CircuitCo/BeagleBone-LCD7-RevA3/README

The BeagleBone LCD7 is a top-level cape with touchscreen capability for use with BeagleBone boards. The top side of this cape features a 7" TFT LCD screen, which can display up to 800x480 resolution, as well as a 4-wire resistive touchscreen and five user buttons. The BeagleBone LCD7 Cape is reset and powered on by buttons. BeagleBone board and other capes are mounted on the backside.
