CircuitCo/BeagleBone-LCD7-RevA3/BeagleBone-LCD7-RevA3-bom.xls

BeagleBone LCD7 Cape |  |  | Revised: | 2012-10-03
BB-BONE-LCD7-01 Revision: A3
TOP LEVEL
ITM | QTY | DESCRIPTION | PART NUMBER | MAN | COMMENT
1 | 4 | #4 PEM NUTS | KFS2-440 | GLOBAL FASTENERS
2 | 4 | STDOFF HEX M/F #4 1.250"L ALUM | 8407K-ND | KEYSTONE
ITM | QTY | REF DESIGNATIORS | PART | PCB FOOTPRINT | DESCRIPTION | MAN | PART #
1 | 5 | C1,C2,C3,C4,C13 | 10uF,10V | 805 | CAP CER 10UF 10V Y5V 0805 | TDK | C2012Y5V1A106Z
2 | 20 | C5,C6,C7,C8,C9,C10,C11,C12,C14,C15,C16,C17,C18,C19,C20,C21,C22,C23,C24,C41 | 0.1uF | 402 | Capacitor 0.1uF 16V 10% 0402 X7R | Kemet | C0402C104K4RACT
3 | 1 | C25 | 6.8pF, 50v | c402-25 | CAP CER 6.8PF 50V C0G 0402 |  | GRM1555C1H6R8DZ01D
4 | 2 | C26,C27 | 22uF, 25v | c1206-40x70 | CAP CER 22UF 25V X5R 1206 |  | GRM31CR61E226KE15L
5 | 1 | C28 | 1nF, 25v | c402-25 | CAP CER 1000PF 50V 10% X7R 0402 |  | GRM155R71H102KA01D
6 | 5 | C29,C31,C32,C33,C35 | 0.22uF | c603-35x45 | CAP CER .22UF 50V Y5V 0603 |  | GRM188F51H224ZA01D
7 | 1 | C30 | 2.2nF | c402-25 | CAP CER 2200PF 50V 10% X7R 0402 |  | GRM155R71H222KA01D
8 | 2 | C34,C36 | 1uF, 10v | c603-35x45 | CAP CER 1.0UF 25V X5R 0603 |  | TMK107BJ105KA-T
9 | 1 | C37 | 4.7uF | c603-35x45 | CAP CER 4.7UF 6.3V X5R 0603 |  | GRM188R60J475ME19D
10 | 2 | C38,C40 | 4.7uF, 25V | c805-35x60 | CAP CER 4.7UF 50V X5R 10% 0805 |  | C2012X5R1H475K
11 | 1 | C39 | 47nF | c402-25 | CAP CER 0.047UF 25V X5R 0402 |  | TMK105B7473KV-F
12 | 1 | D1 | MBRM120L | powermite-case457-04 | DIODE SCHOTTKY 20V 1A POWERMITE |  | MBRM120LT3G
13 | 1 | D2 | BAT54S/SOT | sot23-28x44 | DIODE SCHOTTKY DUAL 30V SOT323 |  | BAT54SWT1G
14 | 2 | D3,D4 | LTST-C190GKT | led2-31sq | LED GREEN CLEAR 0603 SMD |  | LTST-C190GKT
15 | 2 | J1,J2 | MALE HEADER 2x23 | HEADER23X2 |  | MLE | BSTS-123-D-A-16-T-300-LF
16 | 0.25 | J3 | MALE HDR5x2 | HEADER10X2 |  | MLE | BSTS-123-D-A-16-T-300-LF
17 | 1 | J4 | FEMALE HDR5x2 | HEADER10X2 | NN HEADER FMAL 10PS.1" DL GOLD | MLE | SSHS-105-D-02-T-LF
18 | 2 | J5,J6 | FEMALE HEADER 2x23 | HEADER23X2 | NN HEADER FMAL 46PS.1" DL GOLD | MLE | SSHS-123-D-02-T-LF
19 | 1 | L1,L2 | 4.7uH | ind-lqh32m | INDUCTOR 4.7UH 20% 450MA 1210 |  | LQH32CN4R7M23L
20 | 1 | P1 | CONN_PWR1_2.5MM | CONN3-PWR-PJ102A | CONN POWER JACK 2.1MM |  | PJ-002A
21 | 1 | P2 | FH28-60S-0.5SH | conn-fh28-60s | CONN 60POS FPC 0.5MM SMD GOLD |  | FH28-60S-0.5SH(05)
22 | 1 | P3 | SFW4R-1STE1LF | conn4-24x79-sfw | Conn FFC/FPC Connector SKT 4 POS 1mm Solder RA |  | SFW4R-1ST
23 | 1 | P5 | SM02B-BHSS-1 | con2-bhs-jst | 2 Position 3.5mm Pitch Wire to Board Disconnectable Socket | JST | SM02B-BHSS-1-TB(LF)
24 | 1 | Q1 | FMMT458/SOT | sot23-28x44-bec | TRANS HP NPN 400V 225MA SOT23-3 |  | FMMT458TA
25 | 1 | Q2 | DMC56404 | SMini6-F3-B | TRANS PREBIASED DUAL NPN | Diodes, Inc | DDC114YU-7-F
26 | 0 | Q3 | BSS138, DNI |  | MOSFET Nchan 50V 200mA | Diodes Inc. | BSS138-7-F
27 | 20 | R1,R4,R7,R8,R10,R12,R13,R14,R15,R19,R21,R23,R25,R27,R29,R31,R33,R35,R37,R39 | 33402 | 402 | RES 33.0 OHM 1/16W 1% 0402 SMD | Yaego | RC0402FR-0733RL
28 | 20 | R2,R3,R5,R6,R9,R11,R16,R17,R18,R20,R22,R24,R26,R28,R30,R32,R34,R36,R38,R40 | 10402 | 402 | RES 10.0 OHM 1/16W 1% 0402 SMD | Yaego | RC0402FR-0710RL
29 | 0 | R102 | 10, DNI | 402
30 | 2 | R41,R51 | 62 | sm-7351-res-0402 | RES 62 OHM 1/16W 1% 0402 SMD |  | ERJ-2RKF62R0X
31 | 1 | R42 | 196 | 402 | RES 196 OHM 1/16W 1% 0402 SMD |  | ERJ-2RKF1960X
32 | 1 | R43 | 69.8 | sm-7351-res-0402 | RES 69.8 OHM 1/16W 1% 0402 SMD |  | ERJ-2RKF69R8X
33 | 1 | R44 | 40.2 | sm-7351-res-0402 | RES 40.2 OHM 1/16W 1% 0402 SMD |  | ERJ-2RKF40R2X
34 | 1 | R45 | 237 | sm-7351-res-0402 | RES 237 OHM 1/16W 1% 0402 SMD |  | ERJ-2RKF2370X
35 | 1 | R46 | 25 | R402-25 | RES 24.9 OHM 1/16W 1% 0402 SMD |  | ERJ-2RKF24R9X
36 | 1 | R47 | 165 | sm-7351-res-0402 | RES 165 OHM 1/16W 1% 0402 SMD |  | ERJ-2RKF1650X
37 | 1 | R48 | 64.9 | sm-7351-res-0402 | RES 64.9 OHM 1/16W 1% 0402 SMD |  | ERJ-2RKF64R9X
38 | 1 | R49 | 82.5 | sm-7351-res-0402 | RES 82 OHM 1/16W 1% 0402 SMD |  | ERJ-2RKF82R0X
39 | 1 | R50 | 240 | sm-7351-res-0402 | RES 240 OHM 1/16W 1% 0402 SMD |  | ERJ-2RKF2400X
40 | 13 | R52,R53,R71,R72,R75,R78,R79,R80,R81,R82,R83,R92,R93 | 10K | SM-7351-RES-0402 | Resistor 10Kohm 1/16W 5% 0402 | Rohm | MCR01MZPJ103
41 | 1 | R54 | 499K | c402-25 | RES 499K OHM 1/16W 1% 0402 SMD |  | ERJ-2RKF4993X
42 | 1 | R55 | 430K | c402-25 | RES 430K OHM 1/16W 1% 0402 SMD |  | ERJ-2RKF4303X
43 | 1 | R56 | 330K | c402-25 | RES 330K OHM 1/16W 1% 0402 SMD |  | ERJ-2RKF3303X
44 | 2 | R57 | 15K | c402-25 | RES 15K OHM 1/16W 1% 0402 SMD |  | ERJ-2RKF1502X
45 | 0 | R96 | 18K, DNI | c402-25 | RES 18K OHM 1/16W 1% 0402 SMD |  | ERJ-2RKF1802X
46 | 2 | R58,R62 | 56K | c402-25 | RES 56K OHM 1/16W 1% 0402 SMD |  | ERJ-2RKF5602X
47 | 1 | R59 | 750K | c402-25 | RES 750K OHM 1/16W 1% 0402 SMD |  | ERJ-2RKF7503X
48 | 1 | R60 | 680K | c402-25 | RES 680K OHM 1/16W 1% 0402 SMD |  | ERJ-2RKF6803X
49 | 1 | R61 | 130K | c402-25 | RES 130K OHM 1/16W 1% 0402 SMD |  | ERJ-2RKF1303X
50 | 1 | R63 | 330 | r402-25 | RES 330 OHM 1/10W 5% 0402 SMD |  | CRCW0402330RJNED
51 | 1 | R64 | 1E | c402-25 | RES 1.00 OHM 1/16W 1% 0402 SMD | Yaego | RC0402FR-071RL
52 | 2 | R65,R66 | 5.6K,5% | 402 | RES 5.6K OHM 1/16W 5% 0402 SMD | Yaego | RC0402JR-075K6L
53 | 3 | R67,R68,R69 | 4.75K | 402 | RES 4.75K OHM 1/16W 1% 0402 SMD | Stackpole Electronics | RMCF0402FT4K75
54 | 0 | R70,R73,R74,R76,R77 | 10K, DNI | SM-7351-RES-0402 | Resistor 10Kohm 1/16W 5% 0402 | Rohm | MCR01MZPJ103
55 | 8 | R85,R87,R89,R91,R95,R99 | 0 | c402-25 | Resistor Zero ohm Jumper 0402 | Yageo | RC0402JR-070RL
56 | 0 | R84,R86,R88,R90,R97,R98,R100 | 0, DNI | c402-25 | Resistor Zero ohm Jumper 0402 | Yageo | RC0402JR-070RL
57 | 1 | R94 | 470 | r402-25 | RES 470 OHM 1/10W 5% 0402 SMD |  | CRCW0402470RJNED
58 | 1 | R116 | 100K | 402 | RES 100K OHM 1/16W 1% 0402 SMD |  | ERJ-2RKF1003X
59 | 0 | R101 | 100K, DNI | 402 | RES 100K OHM 1/16W 1% 0402 SMD
60 | 1 | SW1 | SW DIP-2 | swdip4_100-339smd | SWITCH TAPE SEAL 2 POS SMD | CTS | 219-2MST
61 | 2 | S1,S6 | B3F-3100 | sw4-b3f-315x | SWITCH TACTILE SPST-NO 0.05A 24V, RA | Omron | B3F-3100
62 | 5 | S2,S3,S4,S5,S7 | B3F-1000 | SWRST4_177X256LS-1 | SWITCH TACTILE SPST-NO 0.05A 24V | Omron | B3F-1000
64 | 1 | U1 | 74avc32t245 | BGA96-ZKE | IC BUS TRANSCVR 32BIT 96BGA | TI | SN74AVC32T245ZKER
65 | 1 | U2 | TPS65105PWP | pwp24-14x70 |  | TI | TPS65105PWPR
66 | 1 | U3 | TPS61080DRC | drc10-11x33 | IC REG LDO CAP FREE 8-SON | TI | TPS61080DRC
67 | 1 | U4 | CAT24C256W | SOIC_8 | IC EEPROM 256KBIT 400KHZ 8SOIC | ON | CAT24C256WI-G
68 | 1 | LCD |  |  | 7" LCD PANEL | TF | TFC-S9700RTWV35TR-01
69 | 1 | PCB |  |  |  |  | BB-BONE-LCD7-PCB-04
