CircuitCo/BeagleBone-LCD7-RevA3/BeagleBone-LCD7-RevA3-schematic.pdf

# 12/14/2011 BBT

# DATE

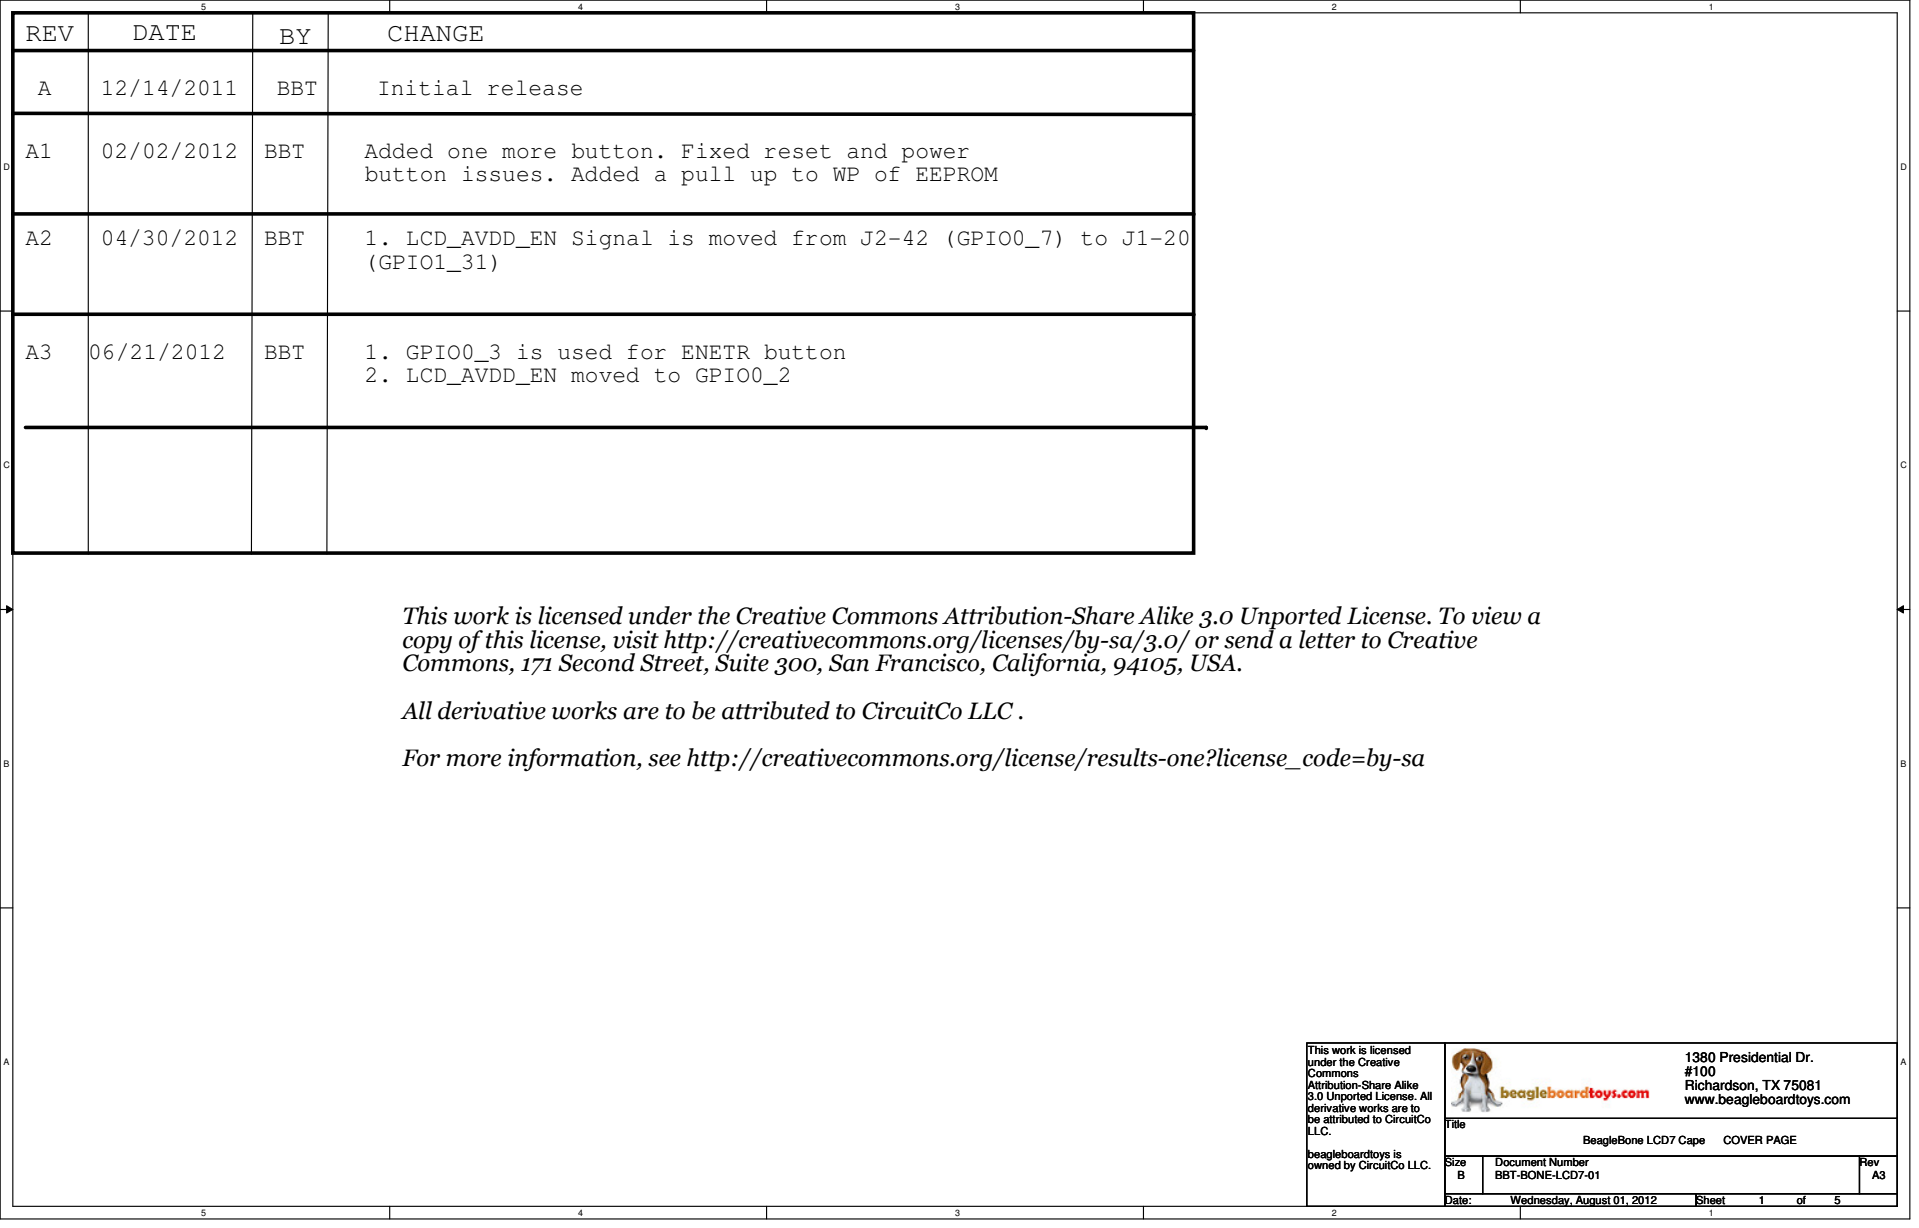
[picture p1: page 1]
REV; CHANGE; Initial release; BBT; Added one more button. Fixed reset and power; 1. LCD_AVDD_EN Signal is moved from J2-42 (GPIO0_7) to J1-20; (GPIO1_31); 1. GPIO0_3 is used for ENETR button; 2. LCD_AVDD_EN moved to GPIO0_2; Title; Size; Document Number; Rev; Date:; Sheet; BBT-BONE-LCD7-01; BeagleBone LCD7 Cape; COVER PAGE; Wednesday, August 01, 2012

button issues. Added a pull up to WP of EEPROM

This work is licensed under the Creative Commons Attribution-Share Alike 3.0 Unported License. To view a
copy of this license, visit http://creativecommons.org/licenses/by-sa/3.0/ or send a letter to Creative
Commons, 171 Second Street, Suite 300, San Francisco, California, 94105, USA.

All derivative works are to be attributed to CircuitCo LLC .

For more information, see http://creativecommons.org/license/results-one?license_code=by-sa

This work is licensed
under the Creative
Commons
Attribution-Share Alike
3.0 Unported License. All
derivative works are to
be attributed to CircuitCo
LLC.

1380 Presidential Dr.
Richardson, TX 75081
www.beagleboardtoys.com

beagleboardtoys is
owned by CircuitCo LLC.

# CONN A IN CONN A OUT

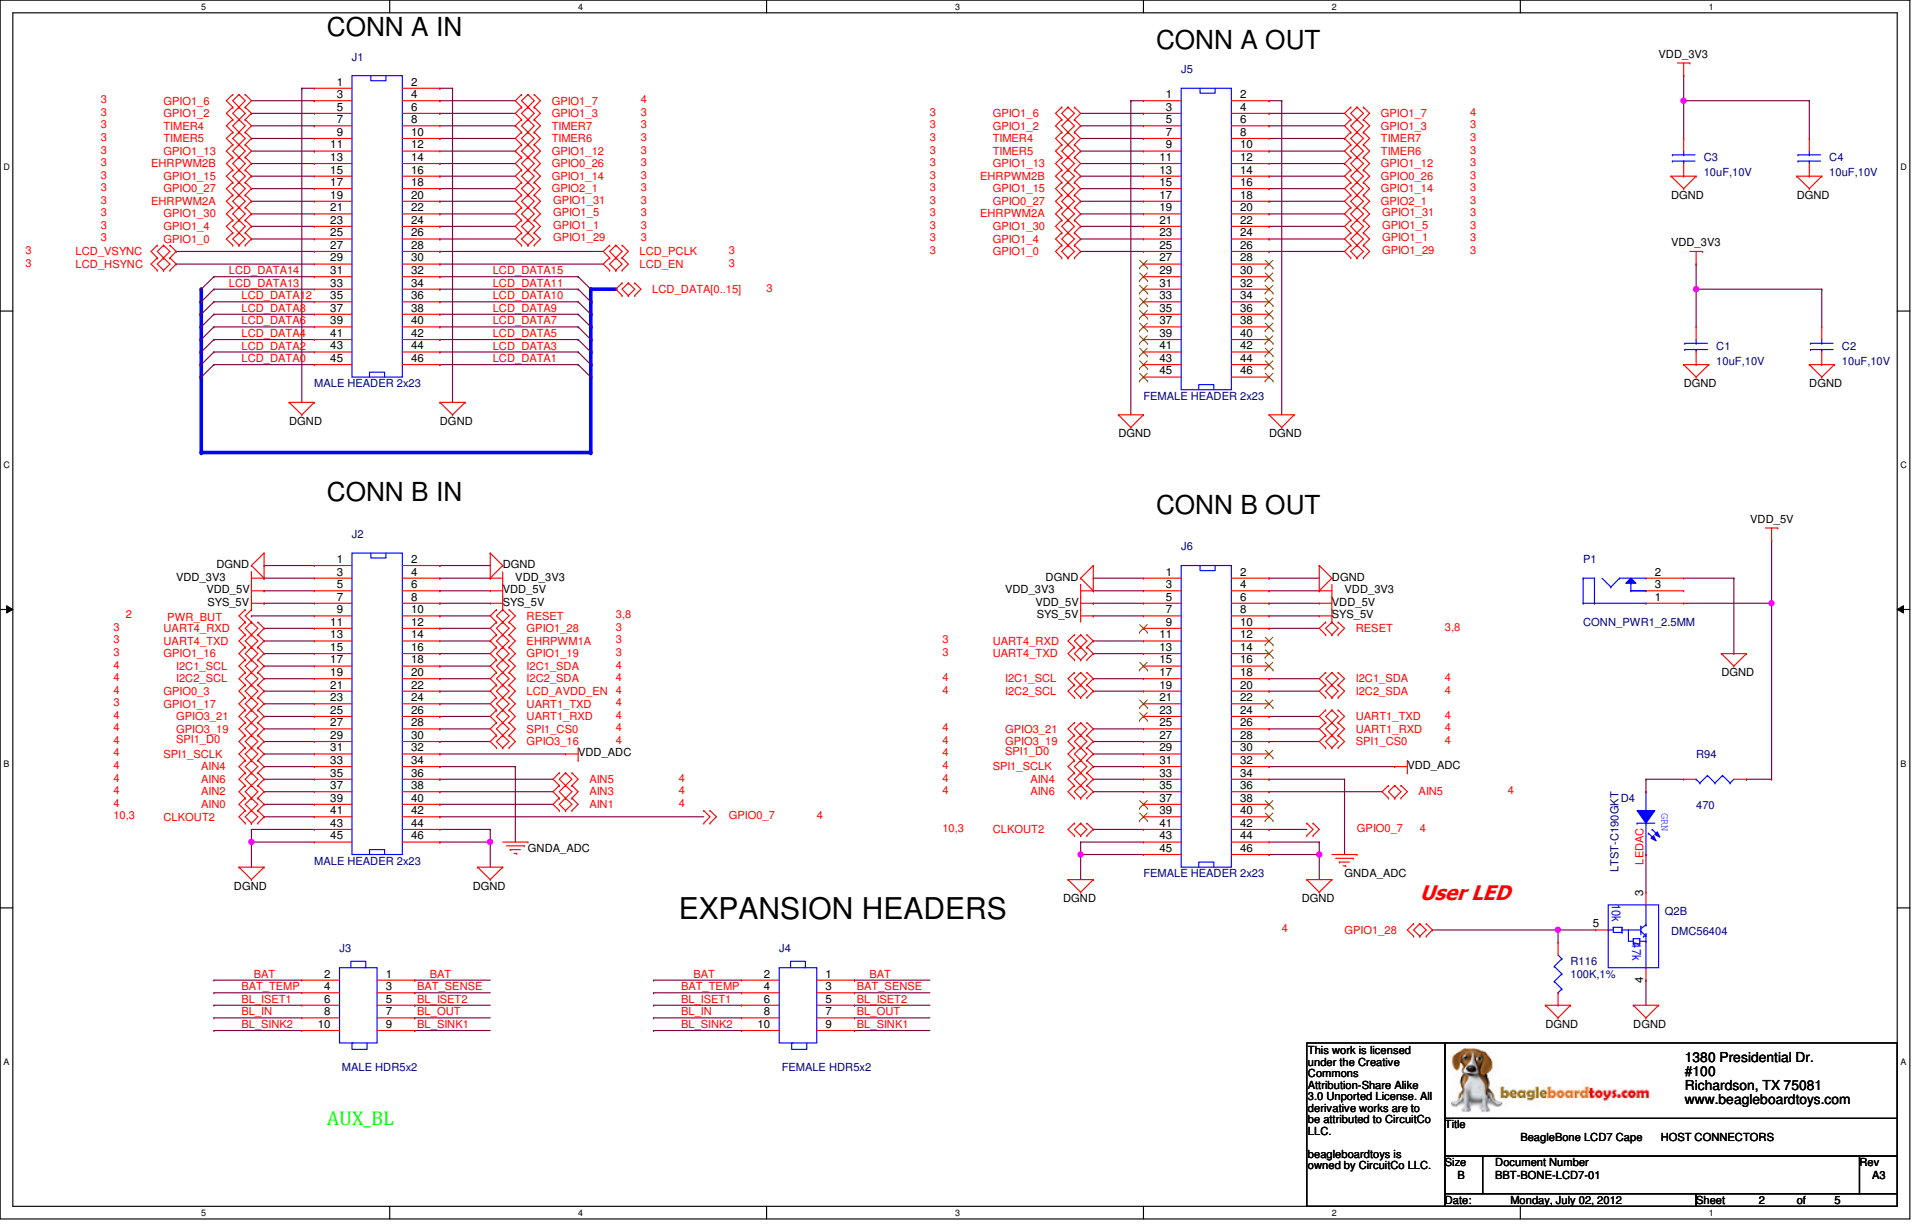
[picture p2: page 2]
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

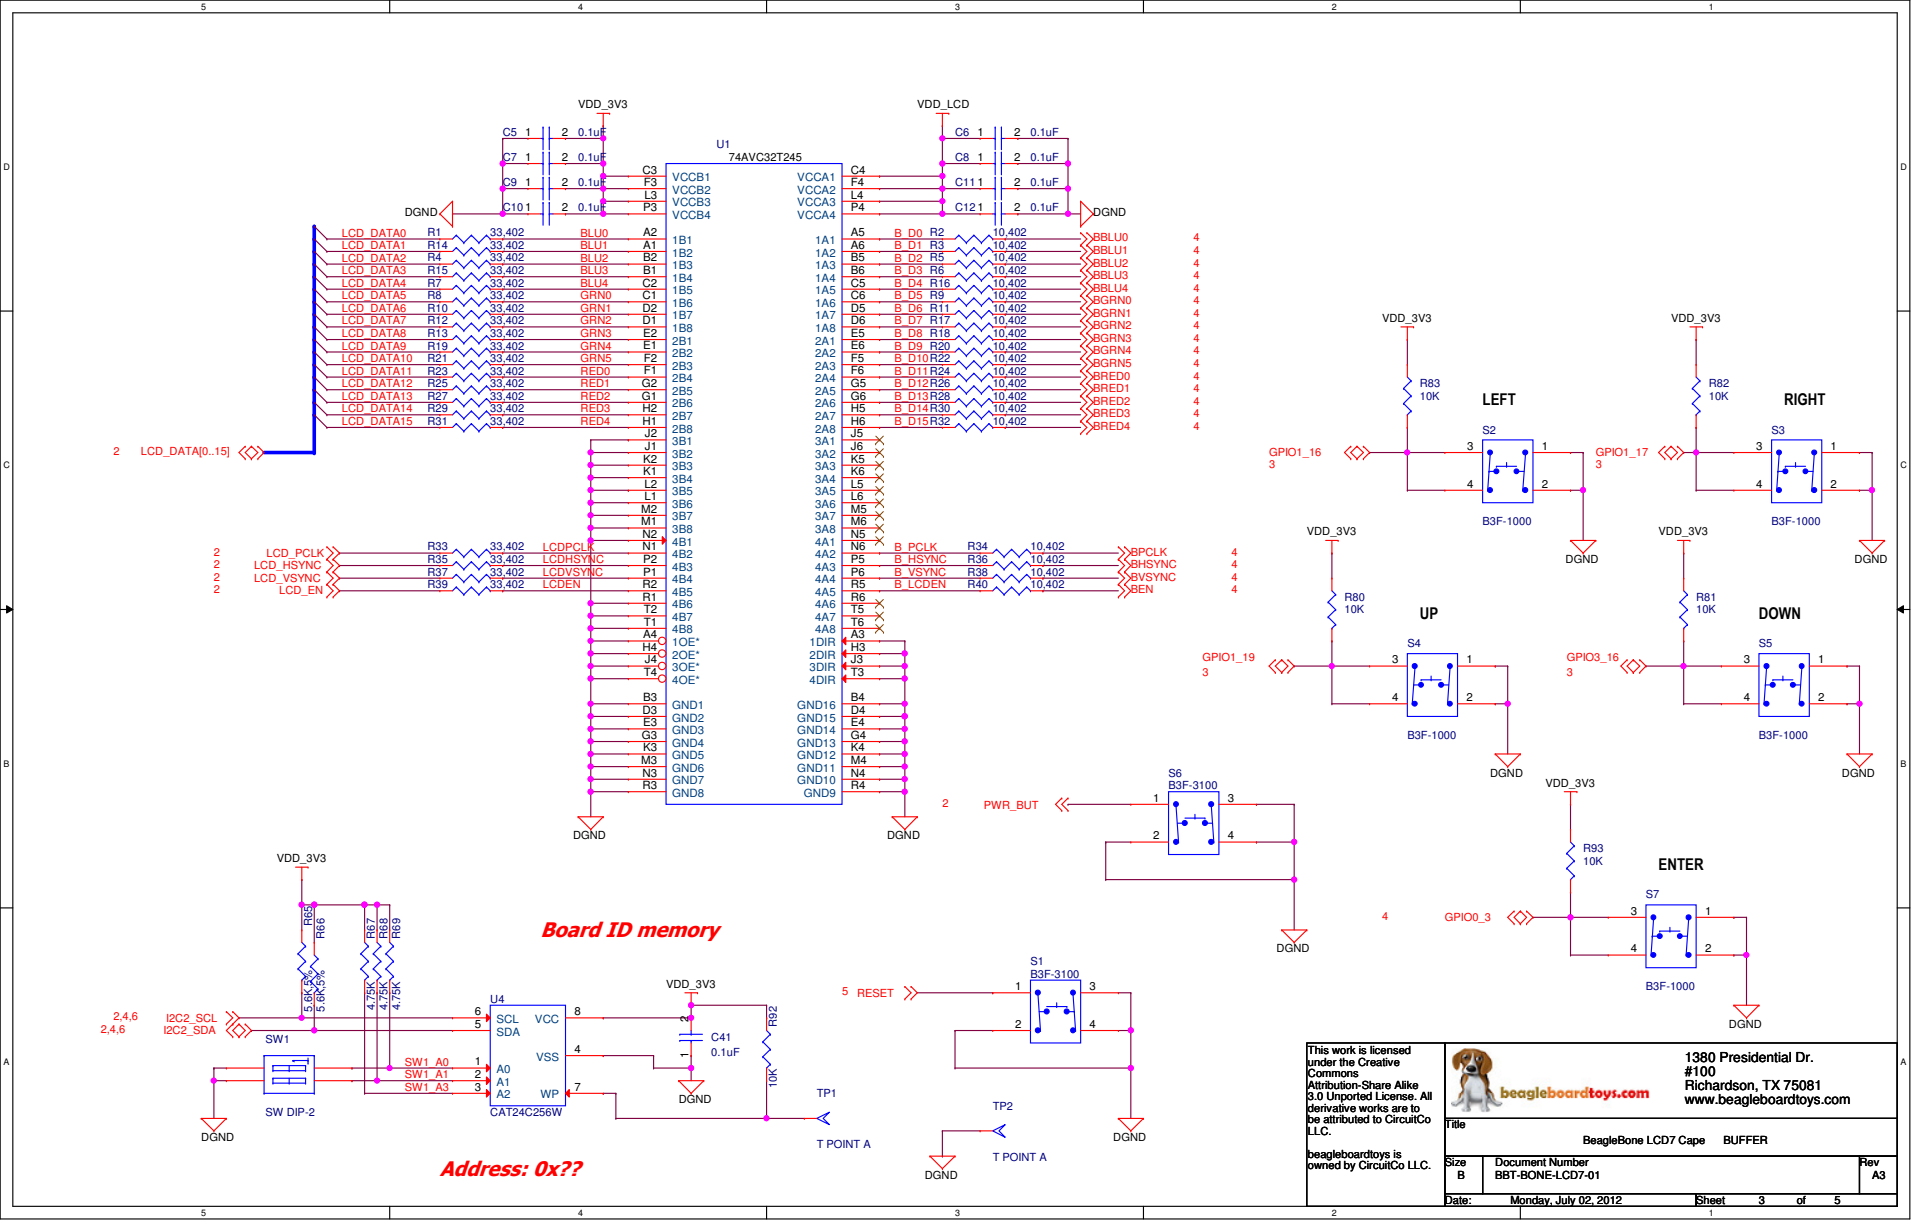
[picture p3: page 3]
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

# Gamma Circuit

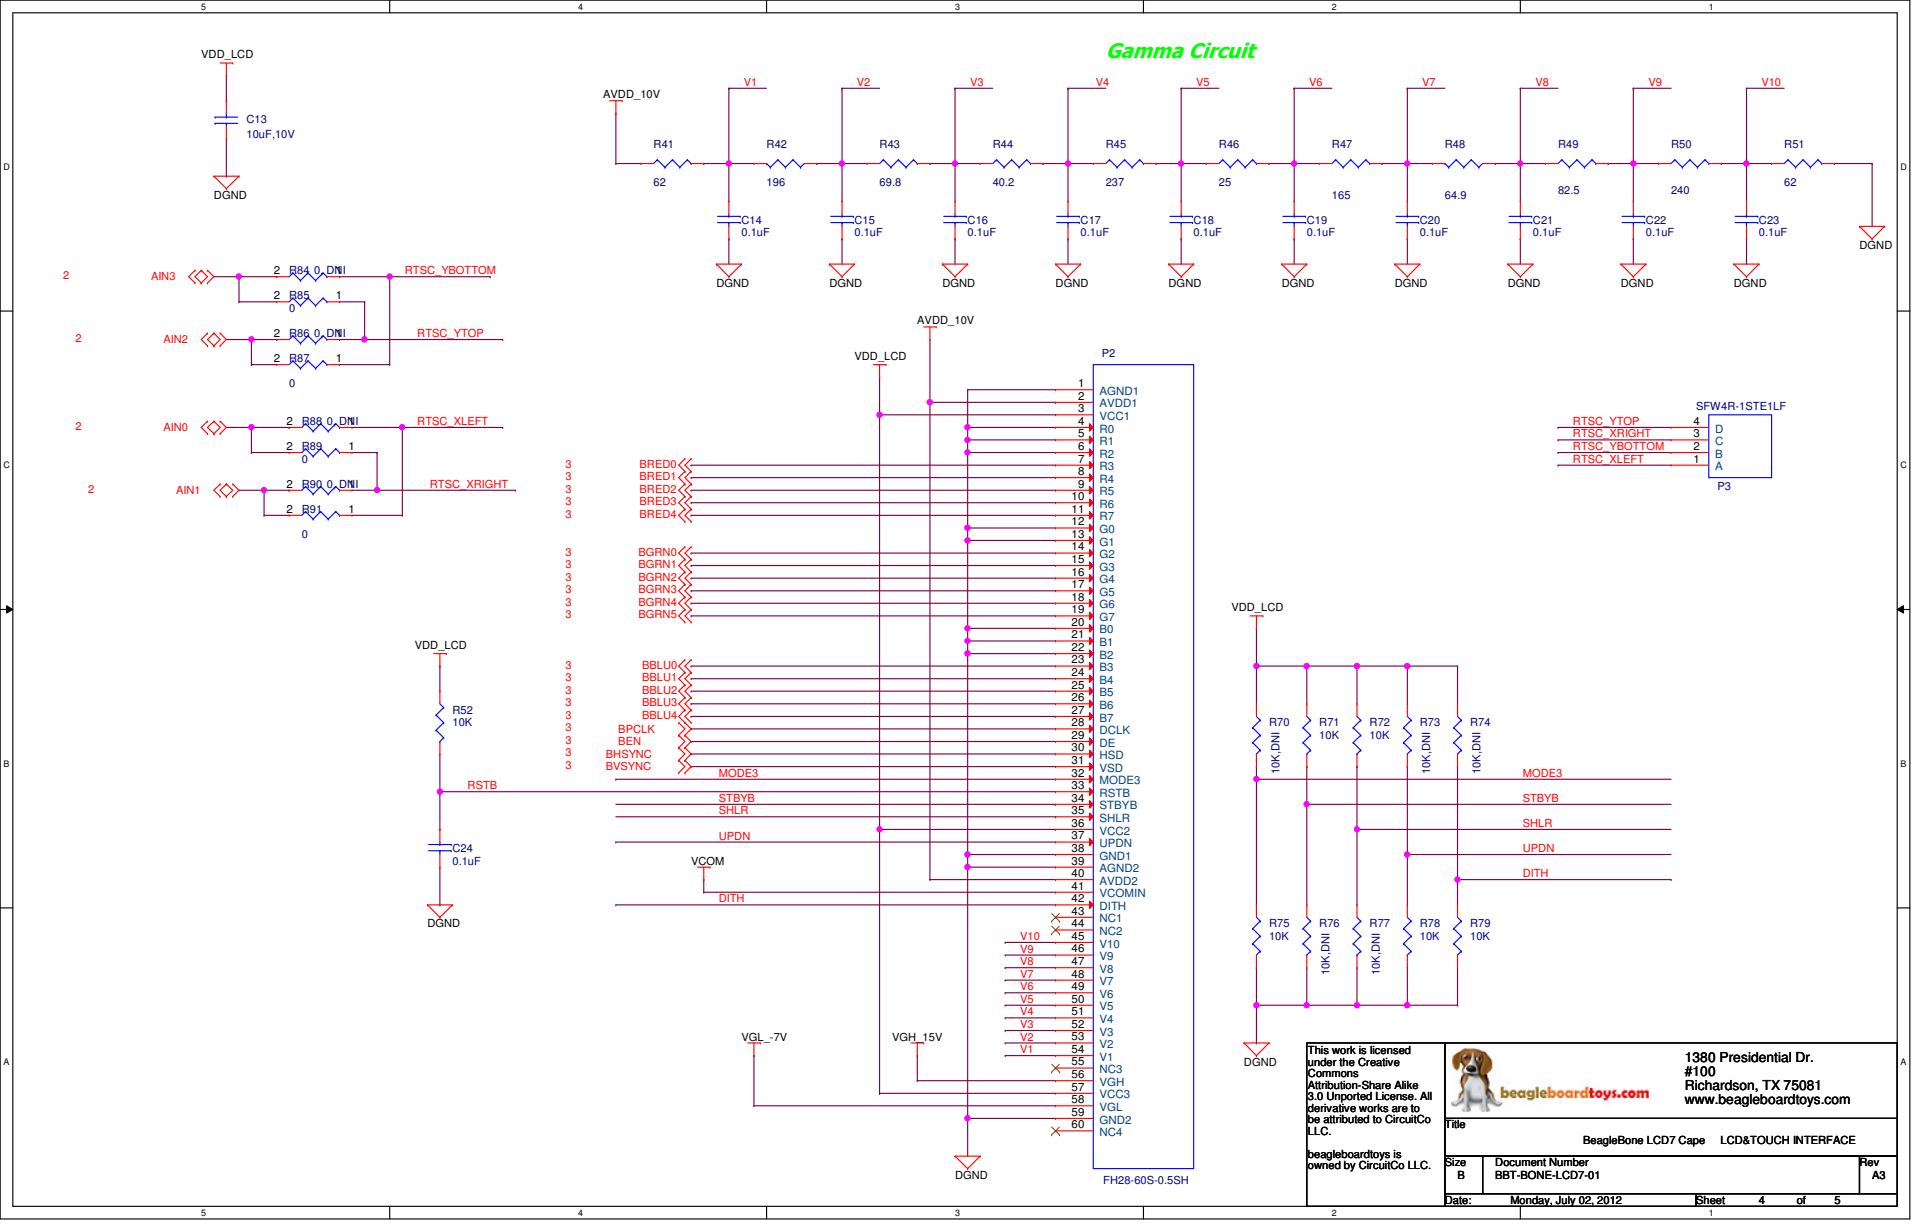
[picture p4: page 4]
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

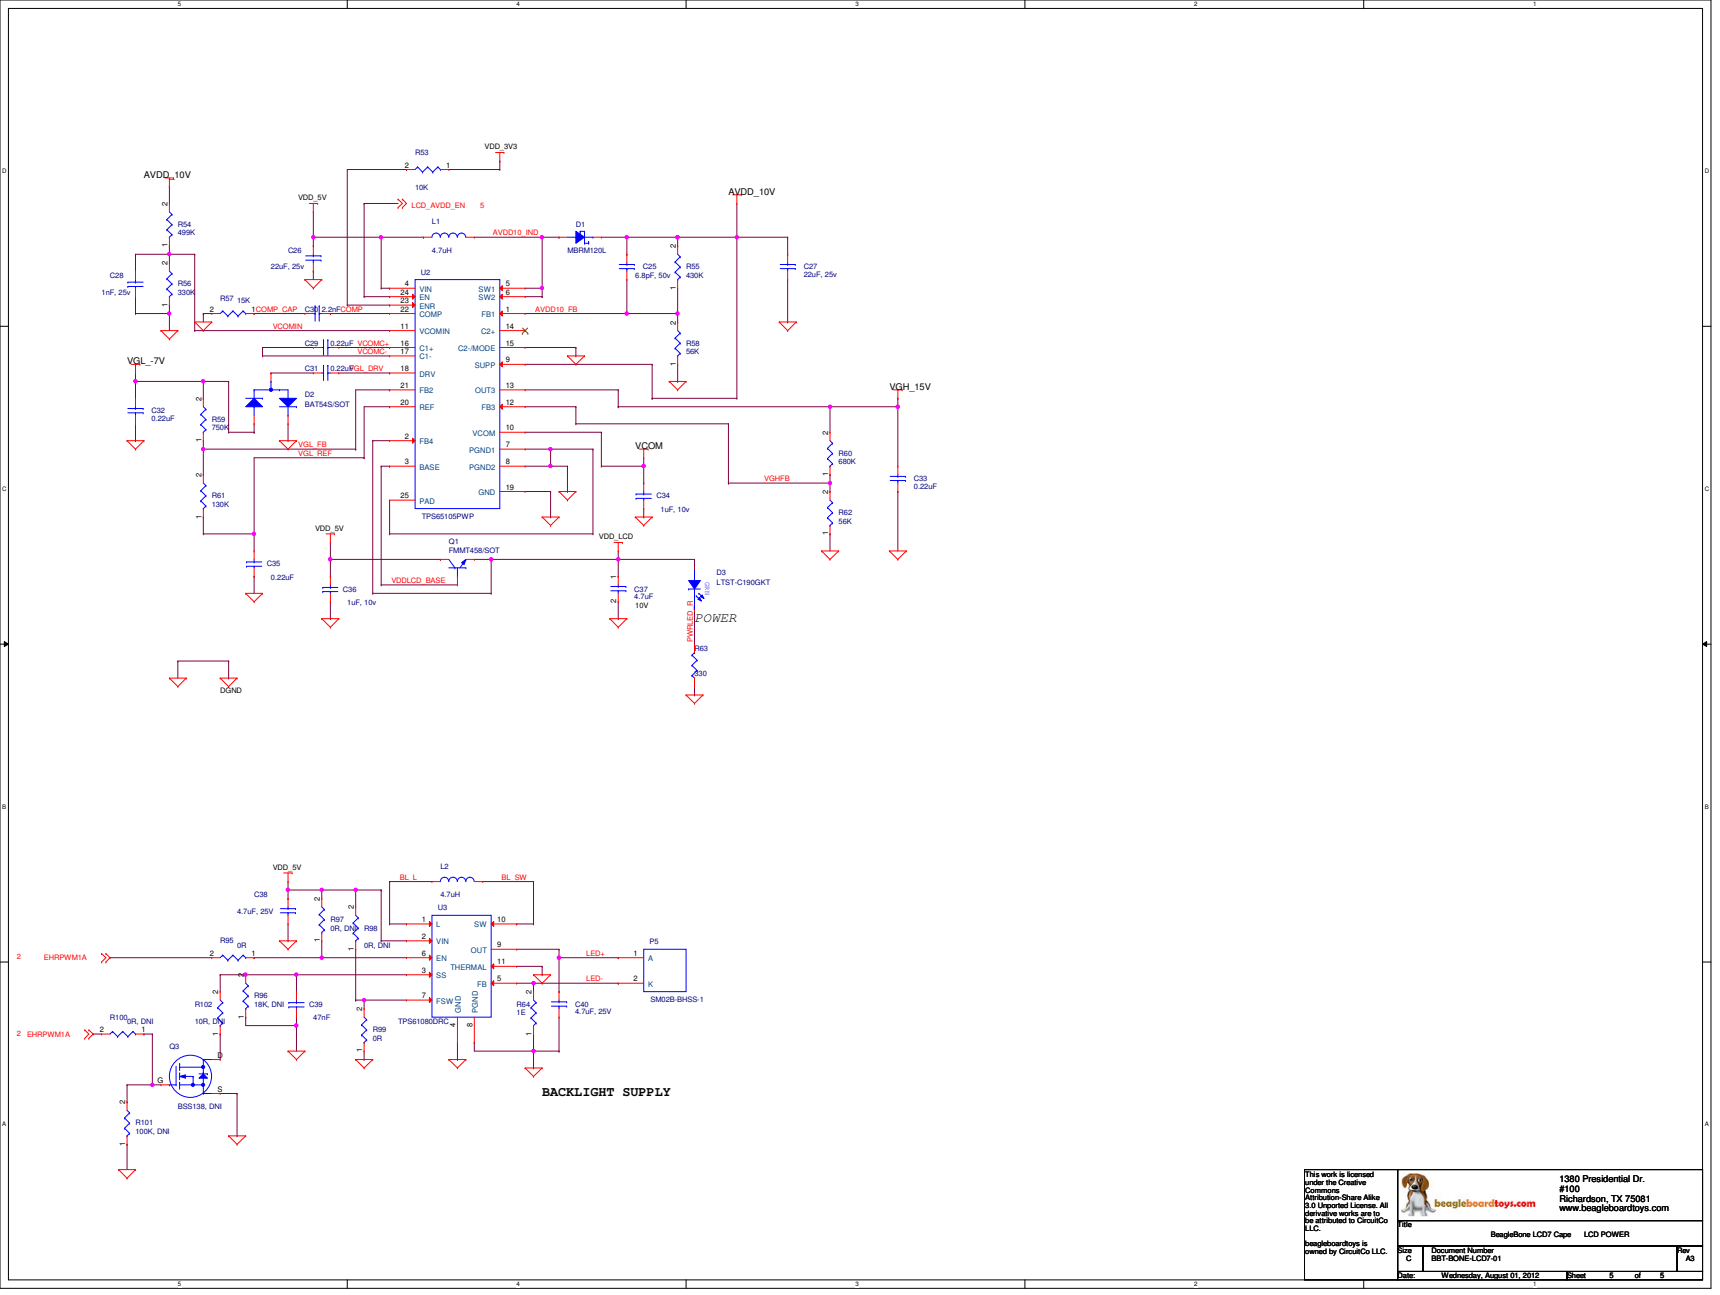
[picture p5: page 5]
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
