CircuitCo/BeagleBone-LCD7-RevA3/(list of files, drawings)

Other design files:
BeagleBone-LCD7-RevA3-schematic.dsn
