CircuitCo/BeagleBone-LCD7-RevA3/(commit log)

2012-10-03 rm bom a3
    [BeagleBone-LCD7-RevA3-bom.xls]
2012-10-03 upd bom a3
    [BeagleBone-LCD7-RevA3-bom.xls]
